SangHyeon-Shin/3D-Printer-IOT-Safety-System-/BOM - 3D Printer IOT Safety System.xlsx

1Set | Name | Quantity
 | Air Quality Monitoring System
 | SHT41 (Temperature/Humidity) | 1
 | ZE08-CH2O (Formaldehyde) | 1
 | PMS7003 (Dust) + adapter | 1
 | SGP41 (VOC Index) | 1
 | MH-Z16 (CO2) | 1
 | M3 Insert Nut
 | M2 Bolt
 | M3 Bolt
 | ESP32 DevkitC V4 | 1
 | Total
