SangHyeon-Shin/3D-Printer-IOT-Safety-System-/CAD/Air Quailty.3mf

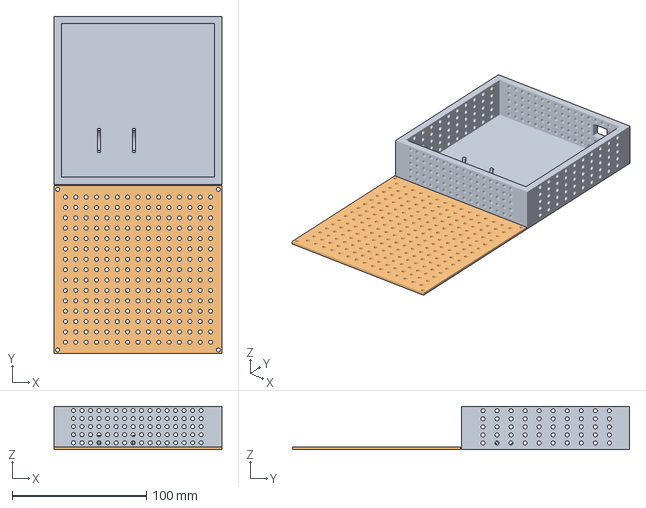
[picture p1: CAD file, 2026-01-31]
CAD/Air Quailty.3mf
125.0 x 251.0 x 32.0 mm
