SangHyeon-Shin/3D-Printer-IOT-Safety-System-/CAD/Air Quality.step

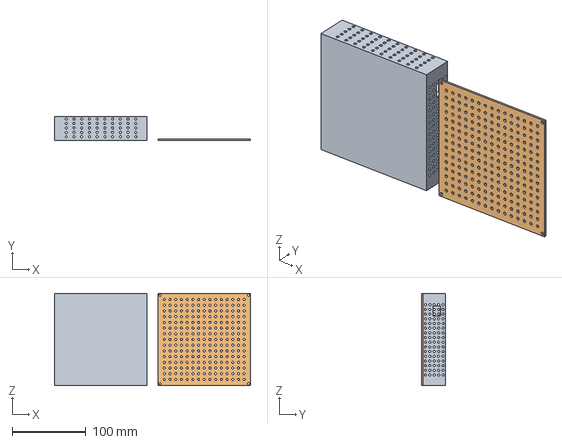
[picture p2: CAD file, 2026-01-31]
CAD/Air Quality.step
265.0 x 32.0 x 125.0 mm
