SangHyeon-Shin/3D-Printer-IOT-Safety-System-/(list of files, cad)

Other CAD files:
CAD/Air Quailty.f3d
